logos-electromechanical/Stellariscope/README.md

Stellariscope
=============

My TI Boosterpack entry -- a driver for 8x8 RGB LED arrays that can be plugged into arrays.
