logos-electromechanical/Stellariscope/stellariscope-BoM.xls

Qty-1 | Part References | Manufacturer Part Number | Manufacturer Name | Description | Notes | Unit Price (Q. 1K) | Extended Price
1 | J1 | S2B-PH-SM4-TB(LF)(SN) | JST Sales America Inc | CONN HEADER PH SIDE 2POS 2MM SMD | Power connector | $0.26050 | $0.26
1 | C6 | C1608X5R1E105M | TDK | CAP CER 1.0UF 25V X5R 0603 | Decoupling cap | $0.02475 | $0.02
1 | R1 | RMCF0603FT2K70 | Stackpole Electronics Inc | RES 2.7K OHM 1/10W 1% 0603 SMD | Current setting resistor | $0.00384 | $0.00384
3 | R2, R3, R4 | RMCF0603FT10K0 | Stackpole Electronics Inc | RES 10K OHM 1/10W 1% 0603 SMD | Pull-{up|down} resistors | $0.00384 | $0.01
2 | U8, U9 | SN74LVC1G32QDBVRQ1 | Texas Instruments | IC SNGL 2IN POS-OR GATE SOT23-5 |  | $0.15000 | $0.30
3 | U6, U7, U10 | SN74LVC1G126DBVR | Texas Instruments | IC BUS BUFF TRI-ST N-INV SOT23-5 |  | $0.13000 | $0.39
7 | C1, C2, C3, C4, C5, C7, C8 | CC0603KRX7R9BB104 | Yageo | CAP CER 0.1UF 50V 10% X7R 0603 | Decoupling caps | $0.00669 | $0.05
2 | C9, C10 | CGA5L3X5R1H106K160AB | TDK Corp | CAP CER 10UF 50V 10% X5R 1206 | Decoupling cap | $0.26100 | $0.52
1 | U5 | SN74LVC2G79DCTR | Texas Instruments | IC DUAL POS D-TYPE F-F SM8 |  | $0.18000 | $0.18
2 | U1, U2 | SN74AHC138PWR | Texas Instruments | IC 3-8 LINE DECODR/DEMUX 16TSSOP |  | $0.16000 | $0.32
2 | VOUT1, VOUT2 | 87264-085 | Molex | CONN RECEPT 2MM 8POS SIDE ENTRY |  | $0.99585 | $1.99
1 | HOUT | 87264-125 | Molex | CONN RECEPT 2MM 12POS SIDE ENTRY |  | $1.18755 | $1.19
2 | VIN1, VIN2 | 87760-081 | Molex | CONN HEADER 8POS 2MM R/A GOLD |  | $0.33314 | $0.67
1 | HIN | 87760-121 | Molex | CONN HEADER 12POS 2MM R/A GOLD |  | $0.64368 | $0.64
1 | U3 | TLC5947DAP | Texas Instruments | IC LED DRIVER LINEAR 32-TSSOP |  | $2.00000 | $2.00
1 | U4 | TLC59213IPWR | Texas Instruments | IC LED DRIVER LINEAR 20-TSSOP |  | $0.70000 | $0.70
2 | Launchpad | 00534 | 4UCON | 1X10PIN GOLD FLASH WITHSTAND HIGH TEMPERATURE | Launchpad connectors | $0.06940 | $0.14
2 | D1 | 00542 | 4UCON | 1X16PIN GOLD FLASH WITHSTAND HIGH TEMPERATURE | LED array connectors | $0.11080 | $0.22
 |  |  |  |  |  | Total | $9.61
