logos-electromechanical/Stellariscope/stellariscope.brd

## EAGLE design stellariscope.brd (2013-12-27)

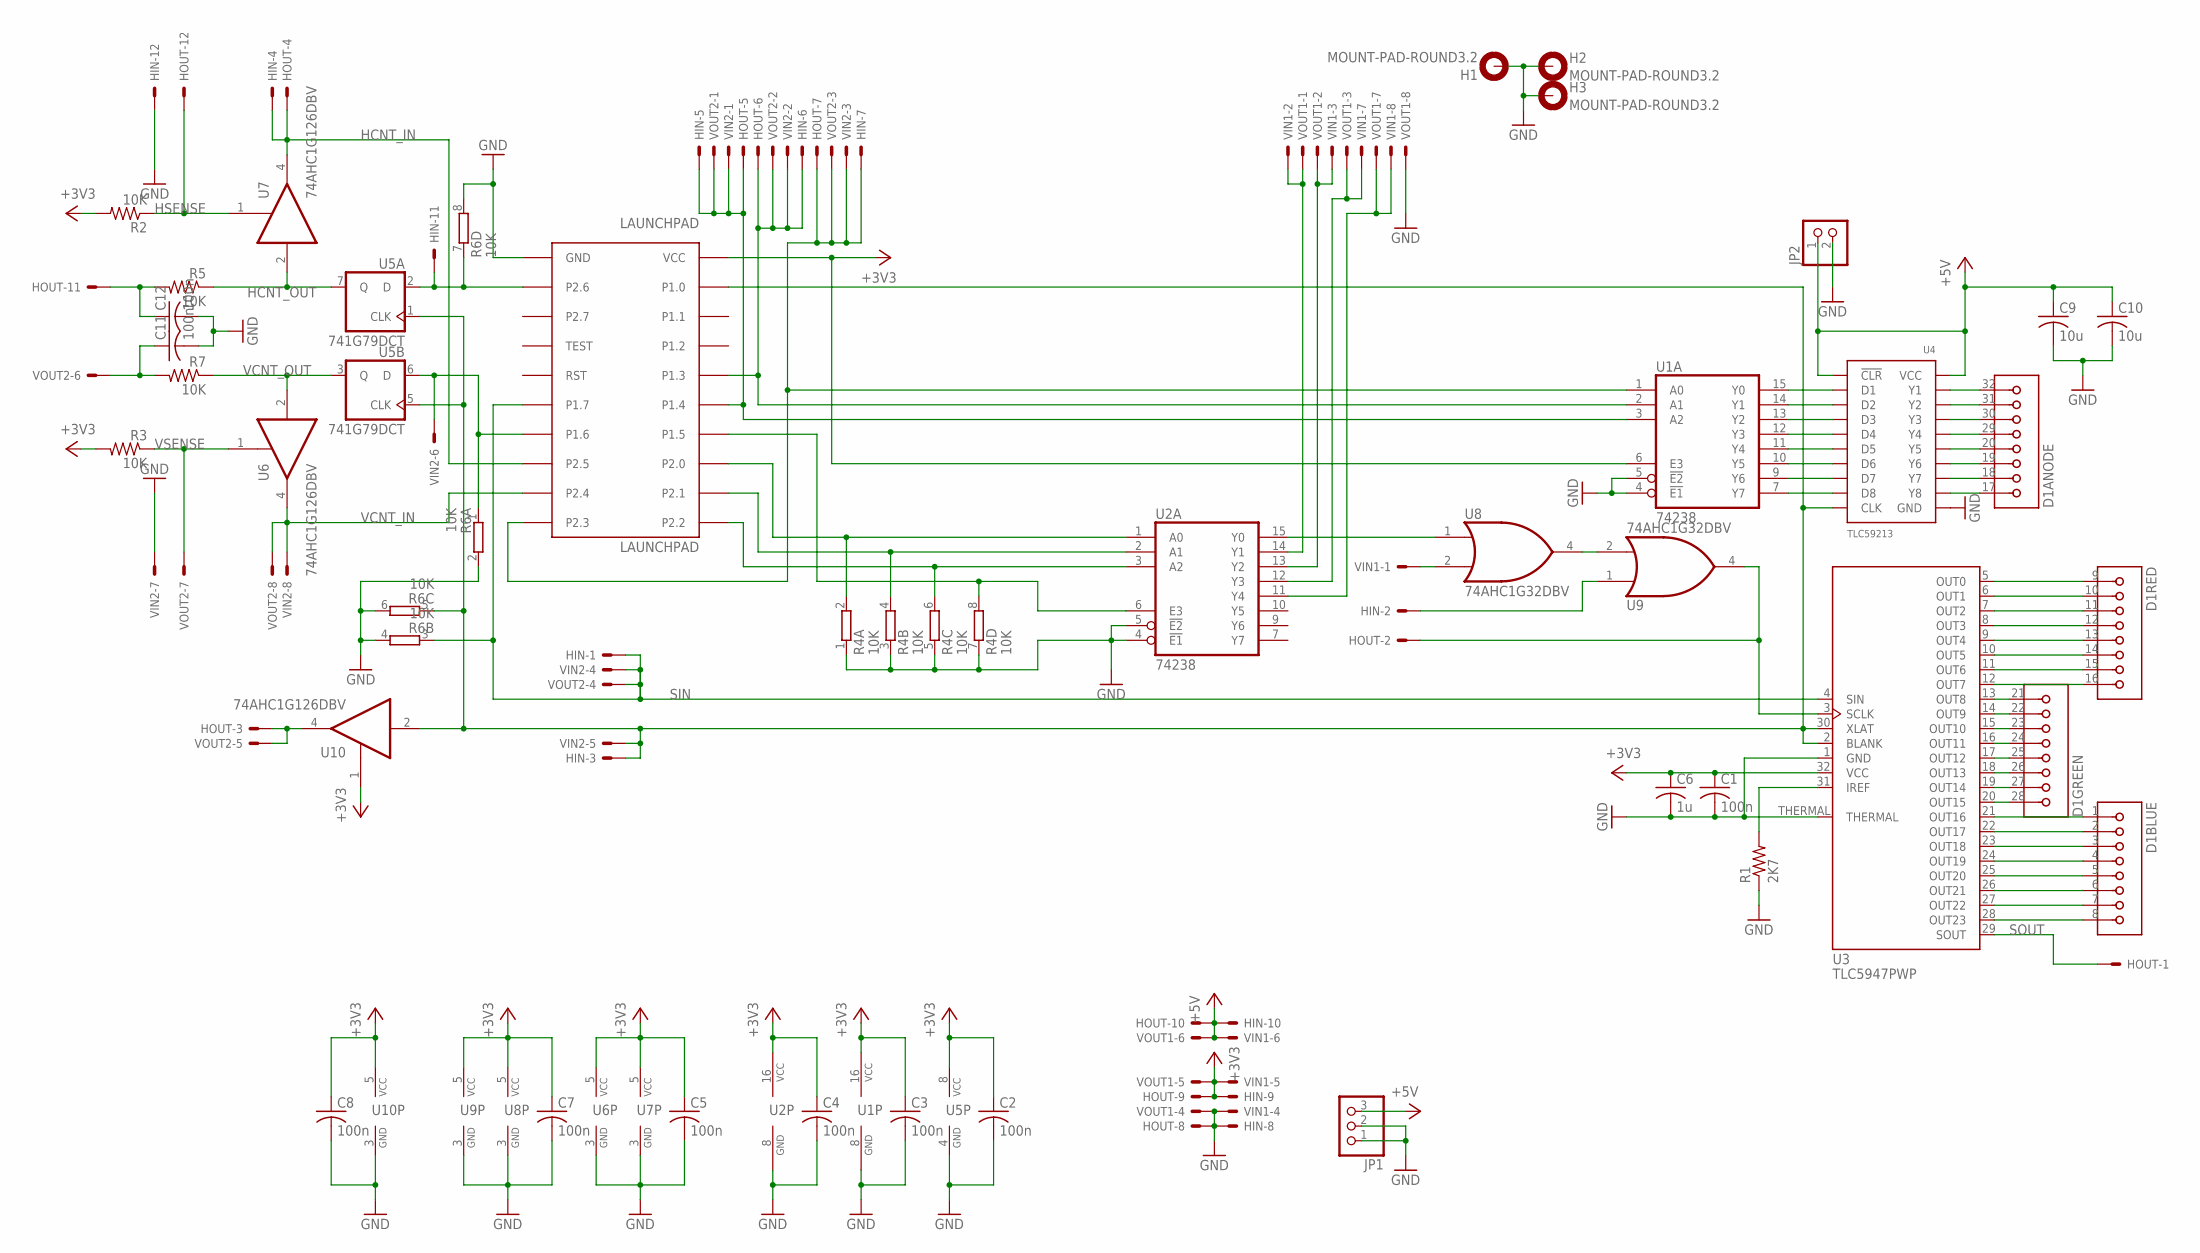
[picture p1: schematic stellariscope.sch]

Parts:
C1, C2, C3, C4, C5, C7, C8, C11, C12: 100n; C0603; PARTNO CC0603KRX7R9BB104
C6: 1u; C0603; PARTNO C1608X5R1E105M
C9, C10: 10u; C1210; PARTNO C3216X5R1E106M
D1: 60MM-8X8-RGB-LED-ARRAY; 60MM-8X8-RGB-MATRIX; PARTNO *
H1, H2, H3: MOUNT-PAD-ROUND3.2; 3,2-PAD
HIN: 87760-121; PARTNO 87760-121
HOUT: 87264-125; PARTNO 87264-125
JP1: PINHD-1X3; 1X03; PARTNO *
JP2: PINHD-1X2_2.54-90°; 1X02/90; PARTNO *
LAUNCHPAD: LAUNCHPAD
R1: 2K7; R0603; PARTNO RMCF0603FT2K70
R2, R3, R5, R7: 10K; R0603; PARTNO RMCF0603FT10K0
R4, R6: 10K; CTS742C083-RES; PARTNO 742C083103JPTR
U1, U2: 74238; TSSOP16; PARTNO CD74HC238PWR
U3: TLC5947PWP; HTSSOP32-PWP; PARTNO TLC5947DAP
U4: TLC59213; TSSOP20; PARTNO TLC59213IPWR
U5: 741G79DCT; DCT_R-PDSO-G8; PARTNO SN74LVC2G79DCTR
U6, U7, U10: 74AHC1G126DBV; SOT23-5; PARTNO SN74LVC1G126DBVR
U8, U9: 74AHC1G32DBV; SOT23-5; PARTNO SN74LVC1G32QDBVRQ1
VIN1, VIN2: 87760-081; PARTNO 87760-081
VOUT1, VOUT2: 87264-085; PARTNO 87264-085

Connections:
+3V3: C1.1, C2.1, C3.1, C4.1, C5.1, C6.1, C7.1, C8.1, HIN.10, HOUT.9, LAUNCHPAD.VCC, R2.2, R3.2, U1.6 (E3), U1.16 (VCC), U2.16 (VCC), U3.32 (VCC), U5.8 (VCC), U6.5 (VCC), U7.5 (VCC), U8.5 (VCC), U9.5 (VCC), U10.1 (OE), U10.5 (VCC), VIN1.5, VOUT1.5
+5V: C9.1, C10.1, HIN.9, HOUT.10, JP1.3, JP2.1, U4.1 (!CLR!), U4.20 (VCC), VIN1.6, VOUT1.6
D1: U1.15 (Y0), U4.2 (D1)
D2: U1.14 (Y1), U4.3 (D2)
D3: U1.13 (Y2), U4.4 (D3)
D4: U1.12 (Y3), U4.5 (D4)
D5: U1.11 (Y4), U4.6 (D5)
D6: U1.10 (Y5), U4.7 (D6)
D7: U1.9 (Y6), U4.8 (D7)
D8: U1.7 (Y7), U4.9 (D8)
GND: C1.2, C2.2, C3.2, C4.2, C5.2, C6.2, C7.2, C8.2, C9.2, C10.2, C11.2, C12.2, H1.B3,2, H2.B3,2, H3.B3,2, HIN.8, HIN.12, HOUT.8, JP1.1, JP1.2, JP2.2, LAUNCHPAD.GND, R1.1, R4.1, R4.3 (1), R4.5 (1), R4.7 (1), R6.2, R6.4 (2), R6.6 (2), R6.8 (2), U1.4 (!E1!), U1.5 (!E2!), U1.8 (GND), U2.4 (!E1!), U2.5 (!E2!), U2.8 (GND), U3.1 (GND), U3.THERMAL, U4.11 (GND), U5.4 (GND), U6.3 (GND), U7.3 (GND), U8.3 (GND), U9.3 (GND), U10.3 (GND), VIN1.4, VIN2.7, VOUT1.4, VOUT1.8
HCNT_IN: HIN.4, HOUT.4, LAUNCHPAD.P2.5, U7.4 (O)
HCNT_OUT: R5.1, U5.7 (Q), U7.2 (I)
HSENSE: HOUT.12, R2.1, U7.1 (OE)
unnamed: D1.9 (1), U3.5 (OUT0)
unnamed: D1.10 (2), U3.6 (OUT1)
unnamed: D1.11 (3), U3.7 (OUT2)
unnamed: D1.12 (4), U3.8 (OUT3)
unnamed: D1.13 (5), U3.9 (OUT4)
unnamed: D1.14 (6), U3.10 (OUT5)
unnamed: D1.15 (7), U3.11 (OUT6)
unnamed: D1.16 (8), U3.12 (OUT7)
unnamed: D1.28 (1), U3.20 (OUT15)
unnamed: D1.27 (2), U3.19 (OUT14)
unnamed: D1.26 (3), U3.18 (OUT13)
unnamed: D1.25 (4), U3.17 (OUT12)
unnamed: D1.24 (5), U3.16 (OUT11)
unnamed: D1.23 (6), U3.15 (OUT10)
unnamed: D1.22 (7), U3.14 (OUT9)
unnamed: D1.21 (8), U3.13 (OUT8)
unnamed: D1.1, U3.21 (OUT16)
unnamed: D1.2, U3.22 (OUT17)
unnamed: D1.3, U3.23 (OUT18)
unnamed: D1.4, U3.24 (OUT19)
unnamed: D1.5, U3.25 (OUT20)
unnamed: D1.6, U3.26 (OUT21)
unnamed: D1.7, U3.27 (OUT22)
unnamed: D1.8, U3.28 (OUT23)
unnamed: HIN.2, U9.1 (I0)
unnamed: R1.2, U3.31 (IREF)
unnamed: U2.12 (Y3), VIN1.7, VOUT1.3
unnamed: C12.1, HOUT.11, R5.2
unnamed: LAUNCHPAD.P1.5, R4.8 (2), U2.6 (E3)
unnamed: U2.15 (Y0), U8.1 (I0)
unnamed: LAUNCHPAD.P2.0, R4.2, U2.1 (A0)
unnamed: LAUNCHPAD.P2.1, R4.4 (2), U2.2 (A1)
unnamed: LAUNCHPAD.P2.2, R4.6 (2), U2.3 (A2)
unnamed: HIN.5, HOUT.5, LAUNCHPAD.P1.4, U1.3 (A2), VIN2.1, VOUT2.1
unnamed: HIN.6, HOUT.6, LAUNCHPAD.P1.3, U1.2 (A1), VIN2.2, VOUT2.2
unnamed: HIN.7, HOUT.7, LAUNCHPAD.P2.3, U1.1 (A0), VIN2.3, VOUT2.3
unnamed: HIN.11, LAUNCHPAD.P2.6, R6.7 (1), U5.2 (D)
unnamed: LAUNCHPAD.P1.6, R6.1, U5.6 (D), VIN2.6
unnamed: U2.14 (Y1), VIN1.2, VOUT1.1
unnamed: U2.13 (Y2), VIN1.3, VOUT1.2
unnamed: U2.11 (Y4), VIN1.8, VOUT1.7
unnamed: C11.1, R7.2, VOUT2.6
unnamed: U8.2 (I1), VIN1.1
unnamed: U8.4 (O), U9.2 (I1)
unnamed: HOUT.2, U3.3 (SCLK), U9.4 (O)
SIN: HIN.1, LAUNCHPAD.P1.7, R6.3 (1), U3.4 (SIN), VIN2.4, VOUT2.4
SOUT: HOUT.1, U3.29 (SOUT)
VCNT_IN: LAUNCHPAD.P2.4, U6.4 (O), VIN2.8, VOUT2.8
VCNT_OUT: R7.1, U5.3 (Q), U6.2 (I)
VSENSE: R3.1, U6.1 (OE), VOUT2.7
XLAT: HIN.3, LAUNCHPAD.P1.0, R6.5 (1), U3.2 (BLANK), U3.30 (XLAT), U4.10 (CLK), U5.1 (CLK), U5.5 (CLK), U10.2 (I), VIN2.5
XLAT_OUT: HOUT.3, U10.4 (O), VOUT2.5
Y1: D1.32 (8), U4.19 (Y1)
Y2: D1.31 (7), U4.18 (Y2)
Y3: D1.30 (6), U4.17 (Y3)
Y4: D1.29 (5), U4.16 (Y4)
Y5: D1.20 (4), U4.15 (Y5)
Y6: D1.19 (3), U4.14 (Y6)
Y7: D1.18 (2), U4.13 (Y7)
Y8: D1.17 (1), U4.12 (Y8)

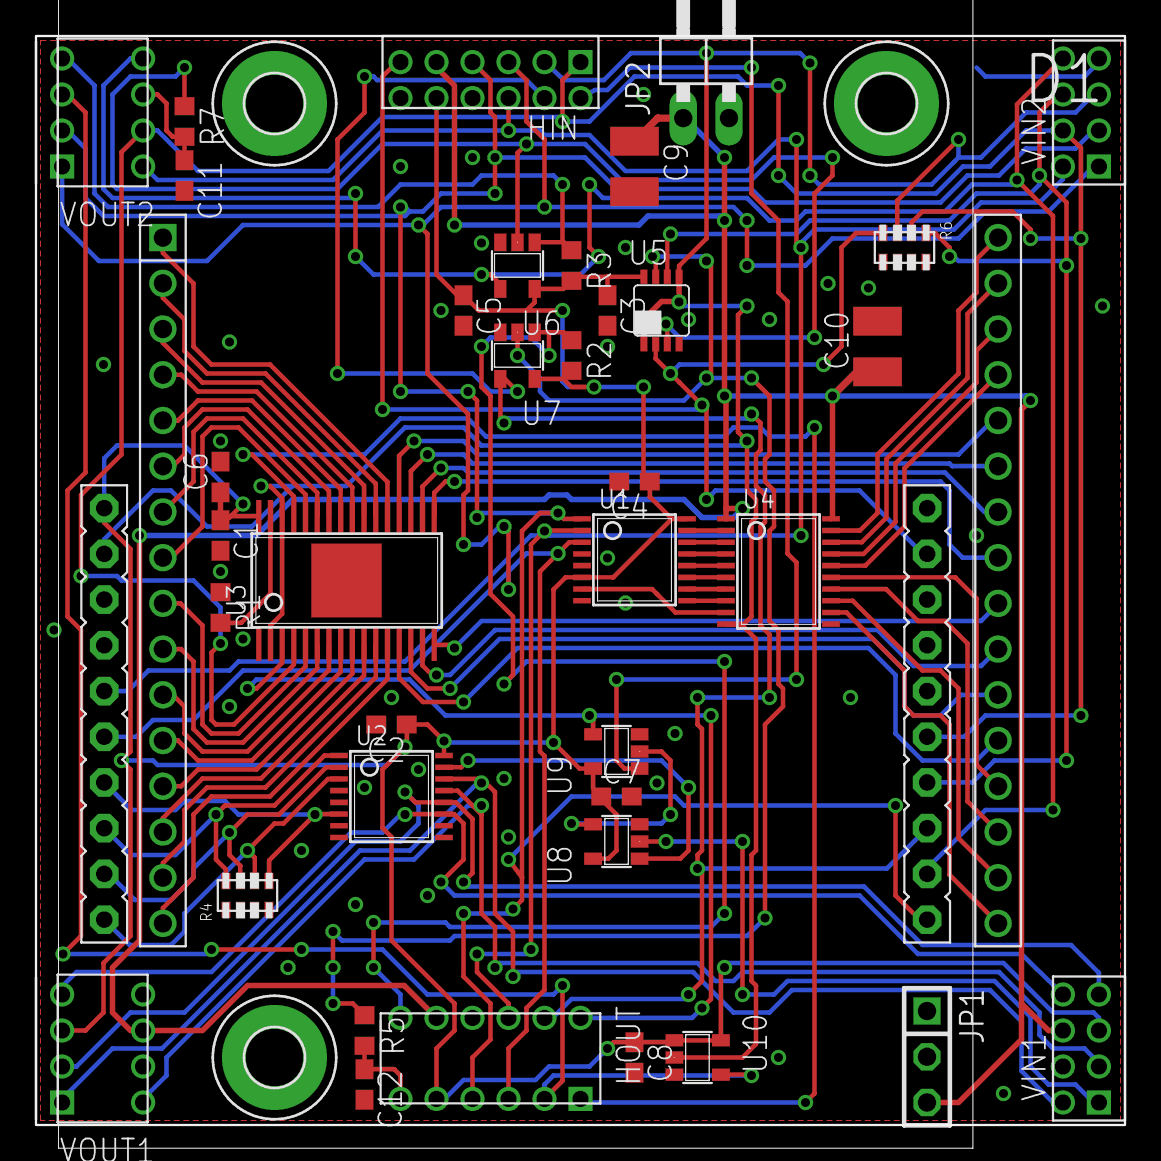
[picture p2: board stellariscope.brd from above]

Board: 2 copper layers, 60.5 x 60.5 mm, 42 parts (0 on the bottom side), 74 nets.
