logos-electromechanical/Stellariscope/(commit log)

2013-02-21 Adding original Stellariscope design. This is the one the prototypes were built from.
    [stellariscope-BoM.xls, stellariscope.brd, stellariscope.sch]
2013-02-21 This update fixes the issues with the board counting logic in the first edition. It also adds a driver to the XLAT line in order to prevent fanout problems in large array. This version has not been b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
    [stellariscope.brd, stellariscope.sch]
2013-02-22 -- Rotated Launchpad footprint to align with LED array -- Swapped vertical connectors to improve routing post-rotation -- Switched power on TLC5947 to 3V3, in order to accomodate logic levels -- Relo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
    [stellariscope.brd, stellariscope.sch]
2013-03-01 -- Moved the old demo code to led test -- First commit of new demo code -- Updated hardware design -- Add 10 uF decoupling caps for board & anode drive -- tied latch and blank lines together
    [stellariscope-BoM.xls, stellariscope.brd, stellariscope.sch]
2013-03-02 -- Modified pinout to allow UART to function correctly
    [stellariscope.brd, stellariscope.sch]
2013-03-02 Fixed the serial issue right this time, miscellaneous test code changes (not done)
    [stellariscope.brd, stellariscope.sch]
2013-06-16 -- added pull-downs to all inputs from the Launchpad -- added delay filters to counting lines so they work now.
    [stellariscope.brd, stellariscope.sch]
2013-12-27 Committing everything to date...
    [stellariscope.brd, stellariscope.sch]
